juanrondon23/SALUS/Salus IV/Mejoras_Salus_IV.docx

# Cosas Necesarias Salus IV

- Borneras para las entradas de potencia de 5V y 7V, además de borneras para la salida a Puente H del driver del motor.
- Agregar mayor cantidad de GPIOs para el uso de más Ultrasonidos.
- Pensar como reemplazar PixHawk.
- Agregar Leds que indiquen el encendido de la placa y no depender de la ESP32 o Rasp.
- Amplificador para incluir un parlante.
- Agujeros pasantes para los tornillos.
- Agregarle las resistencias necesarias de Pull-Down para transistores.
- Incluir Step-Downs dentro de la PCB (Preguntar bien si lo vamos a hacer asi).

# Cosas que no funcionaron o quedaron por funcionar de PCB Salus III

# Cosas que podríamos mejorar de la placa de Salus III
