juanrondon23/SALUS/PCB_Salus_II_Prototipo_1/Prueba.pdf

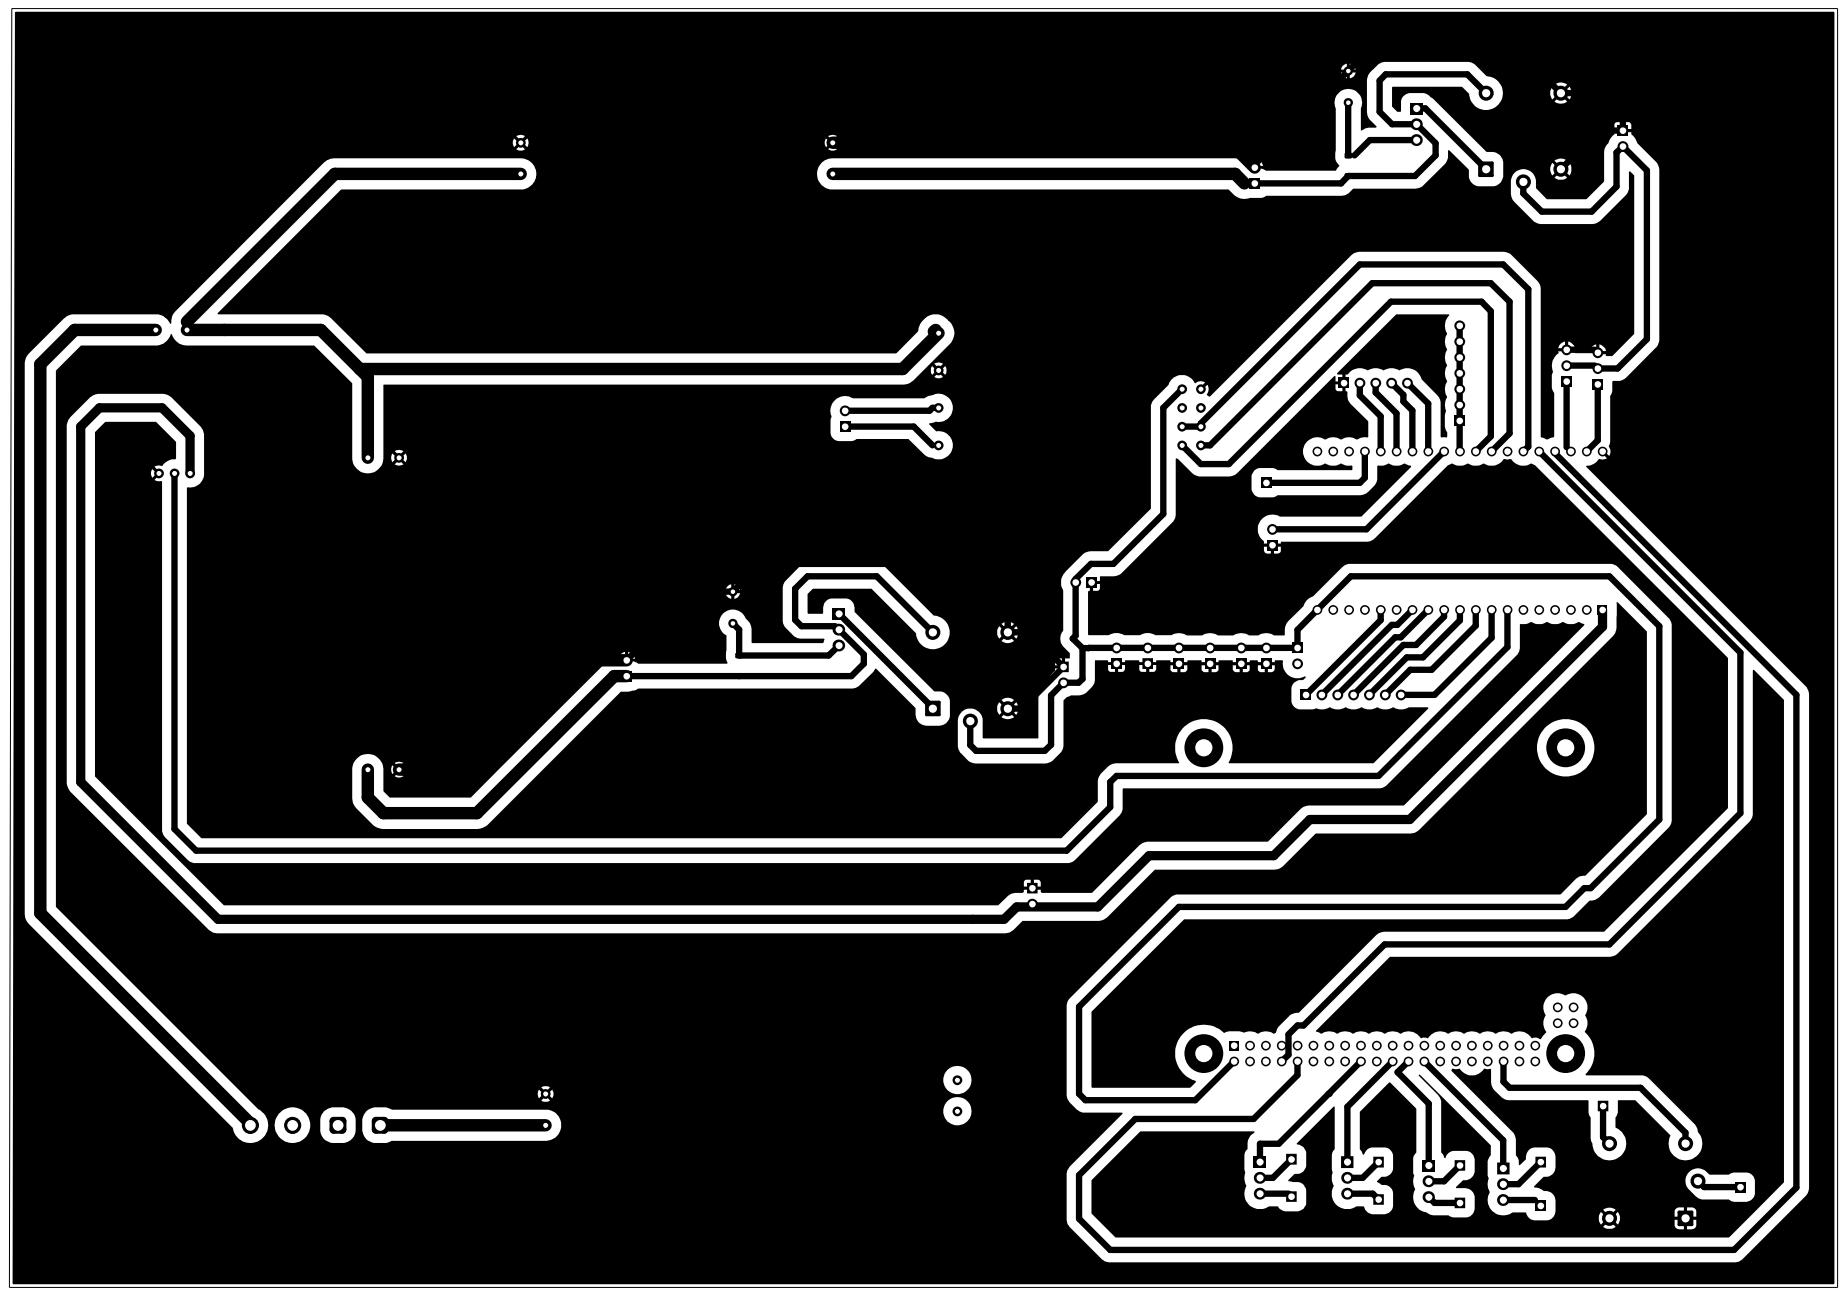
[picture p9: page 1]
