juanrondon23/SALUS/Huellas y Simbolos StepDowns/HUELLAS.pdf

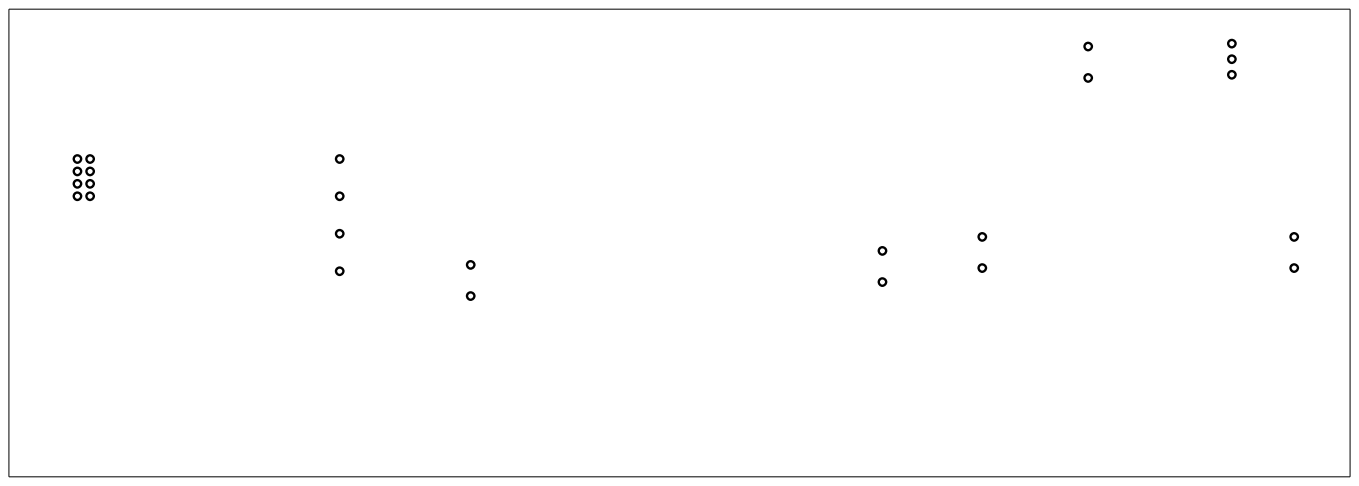
[picture p10: page 1]
