juanrondon23/SALUS/PCB_Salus_II_Prototipo_1/IMPRIMIR SIN HOJA DE DIBUJO.pdf

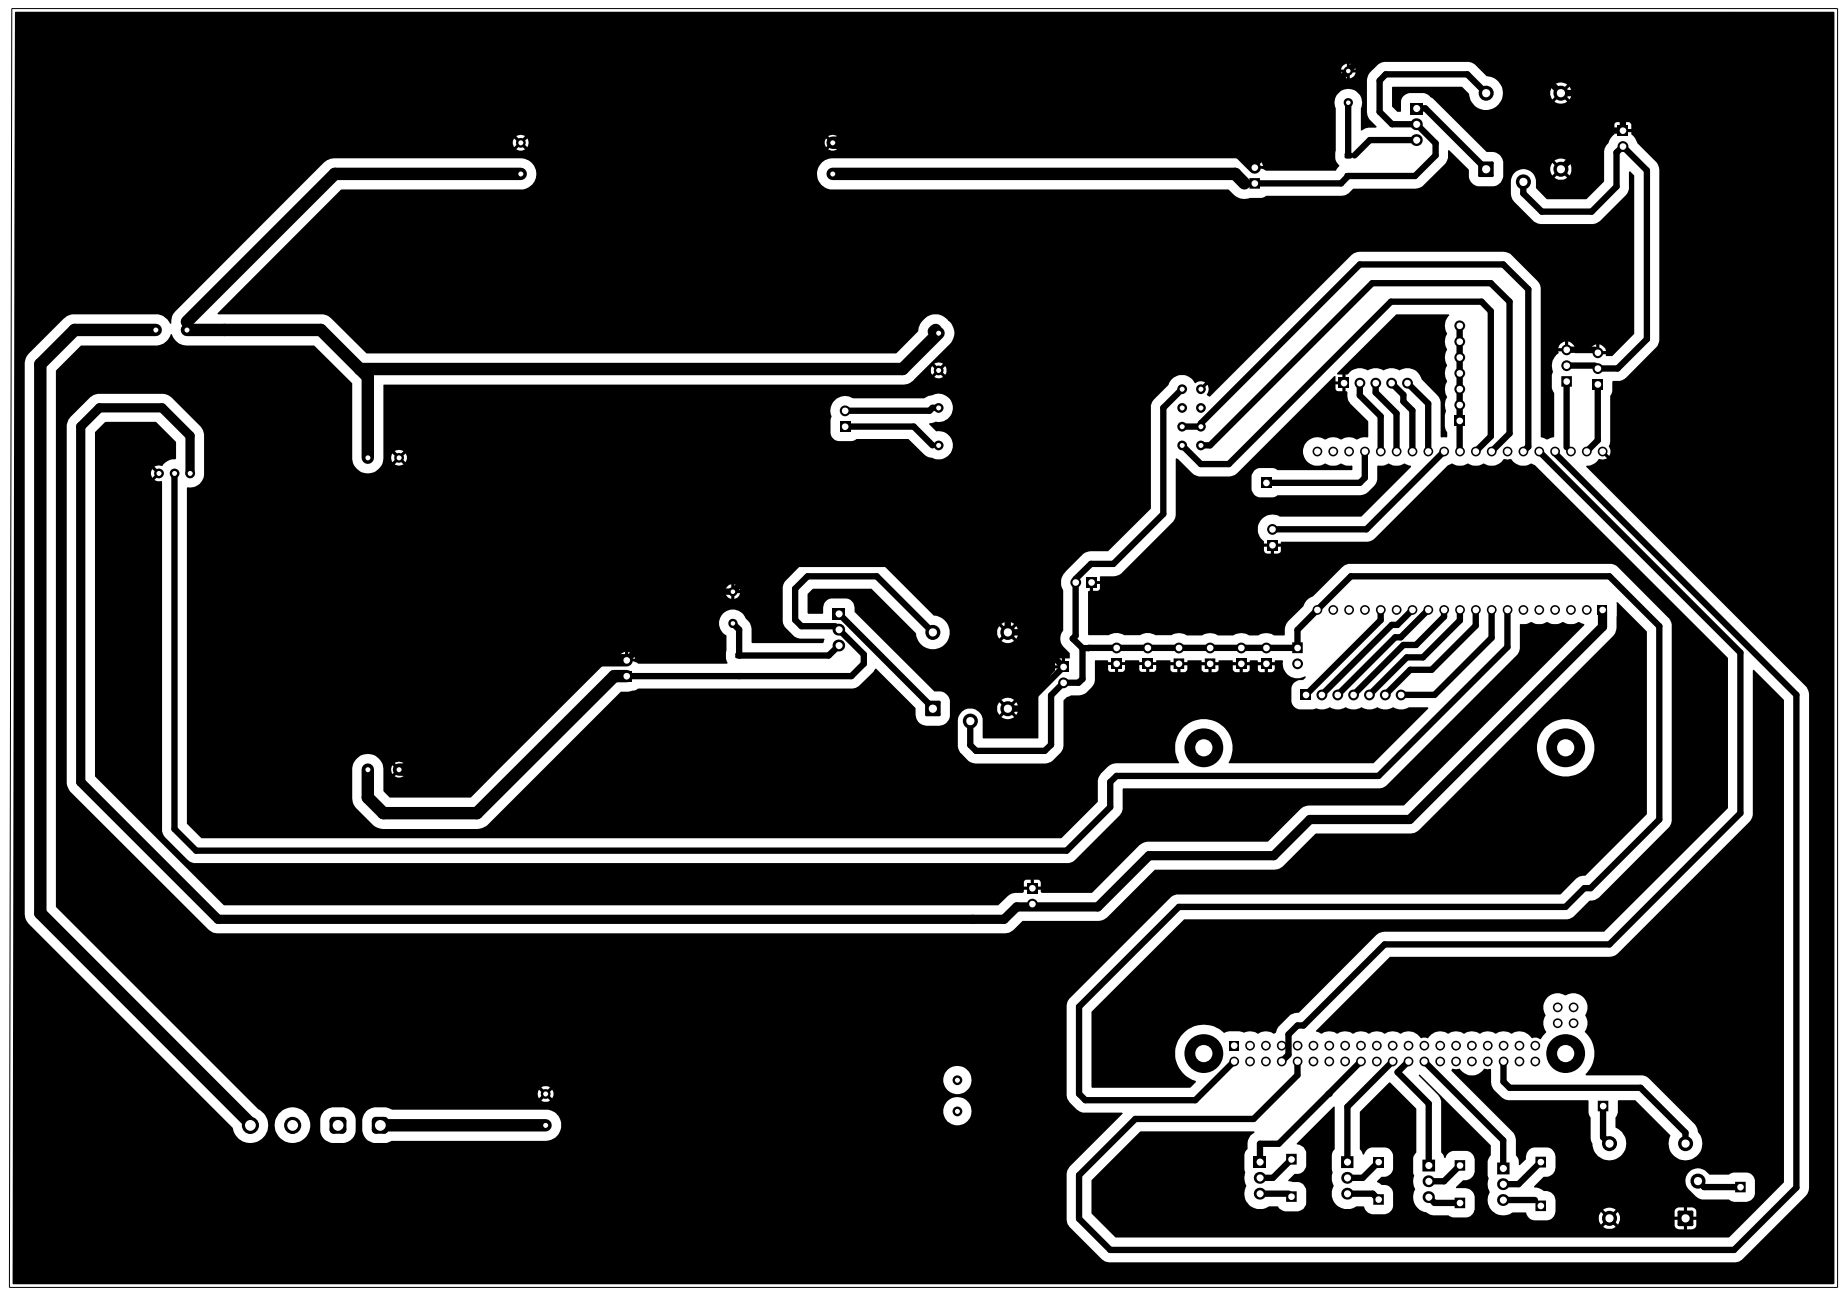
[picture p11: page 1]
