juanrondon23/SALUS/PCB_Salus_II_Prototipo_1/PCB_Salus_II_Prototipo_1-F_Cu.pdf

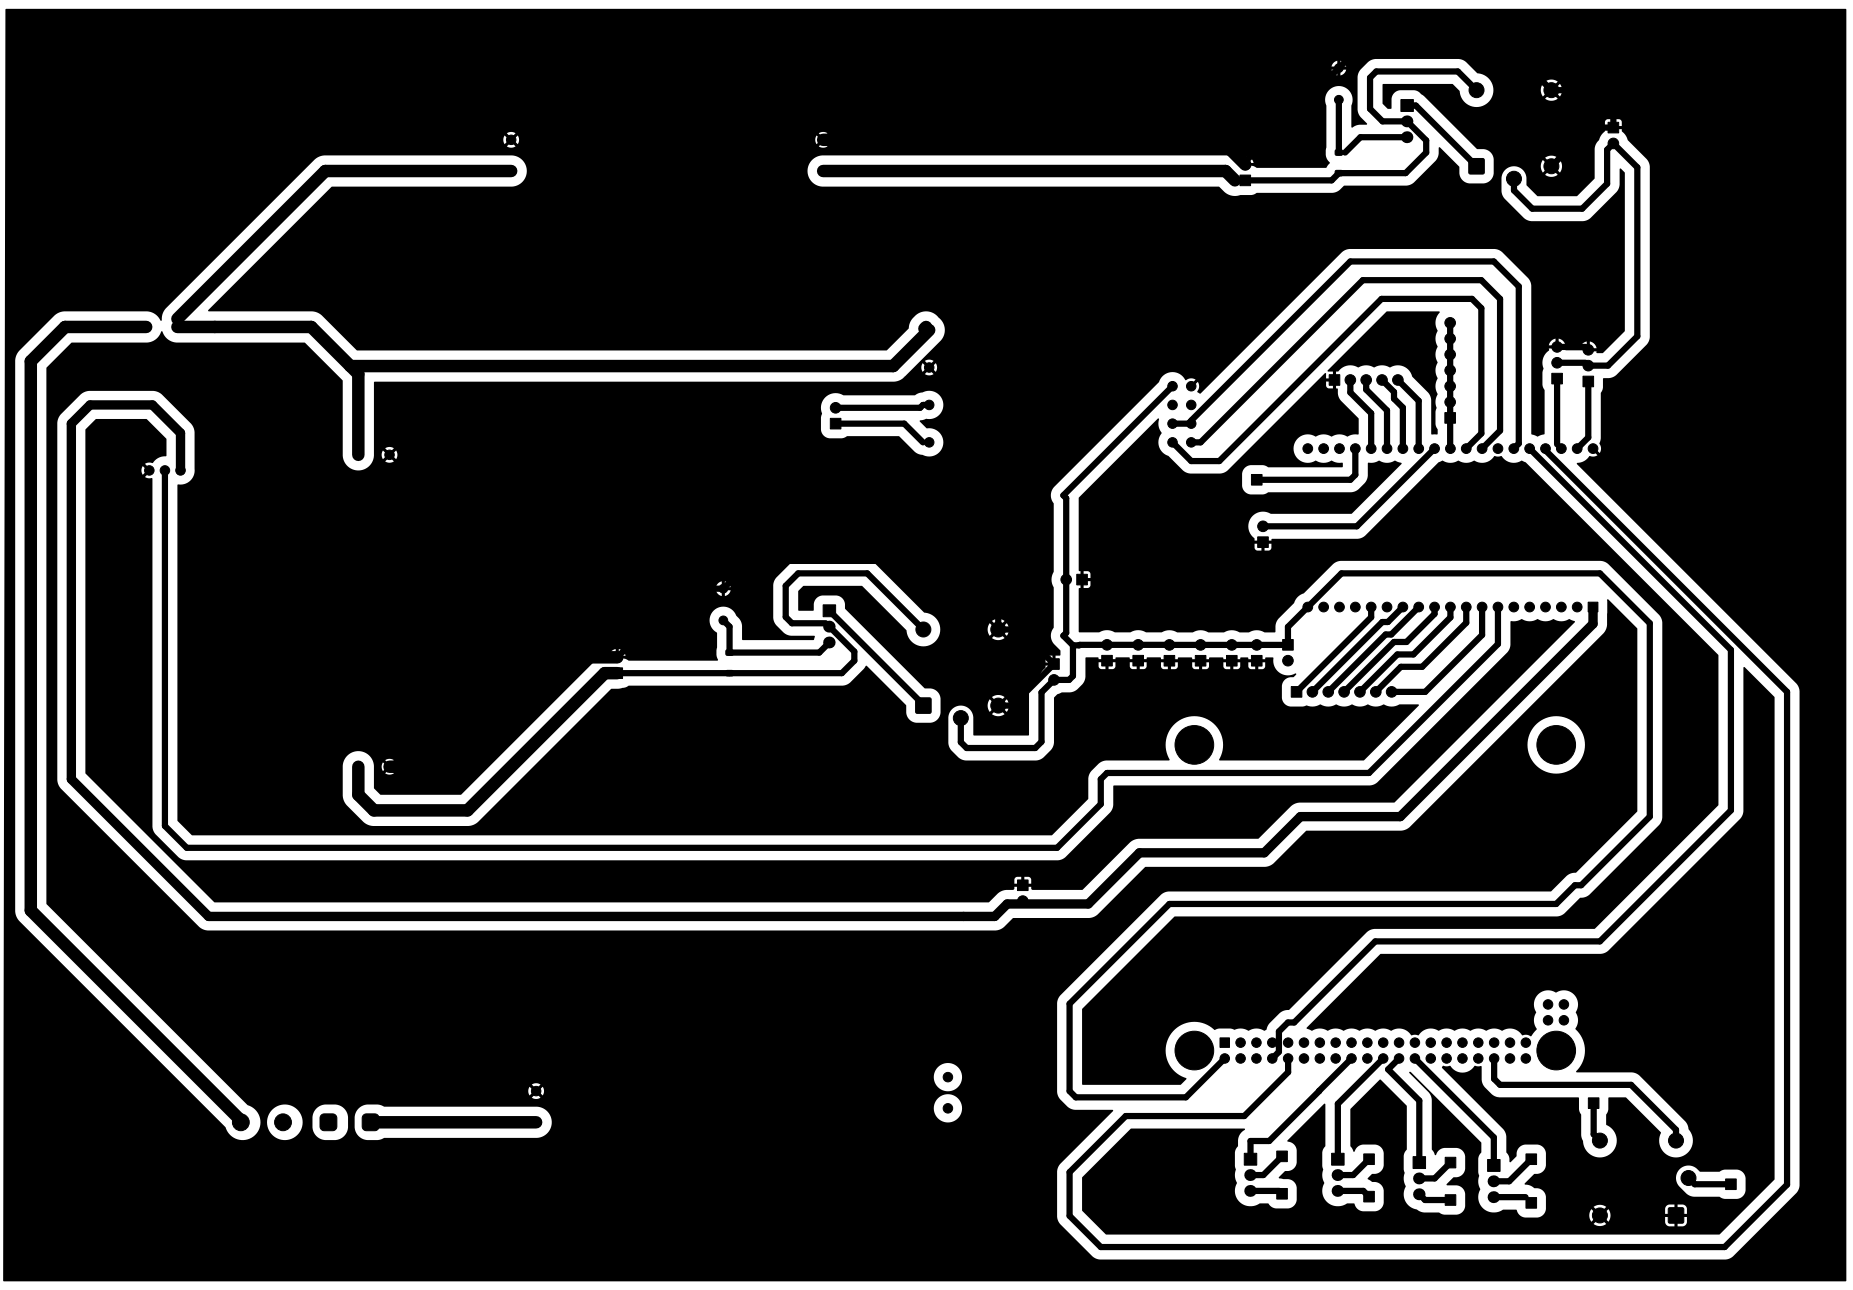
[picture p12: page 1]
