juanrondon23/SALUS/Salus III/PCB/PCB_SALUS_III/PCB_SALUS_III.kicad_pcb

## KiCad design Salus III/PCB/PCB_SALUS_III/PCB_SALUS_III.kicad_pcb (2025-12-04)

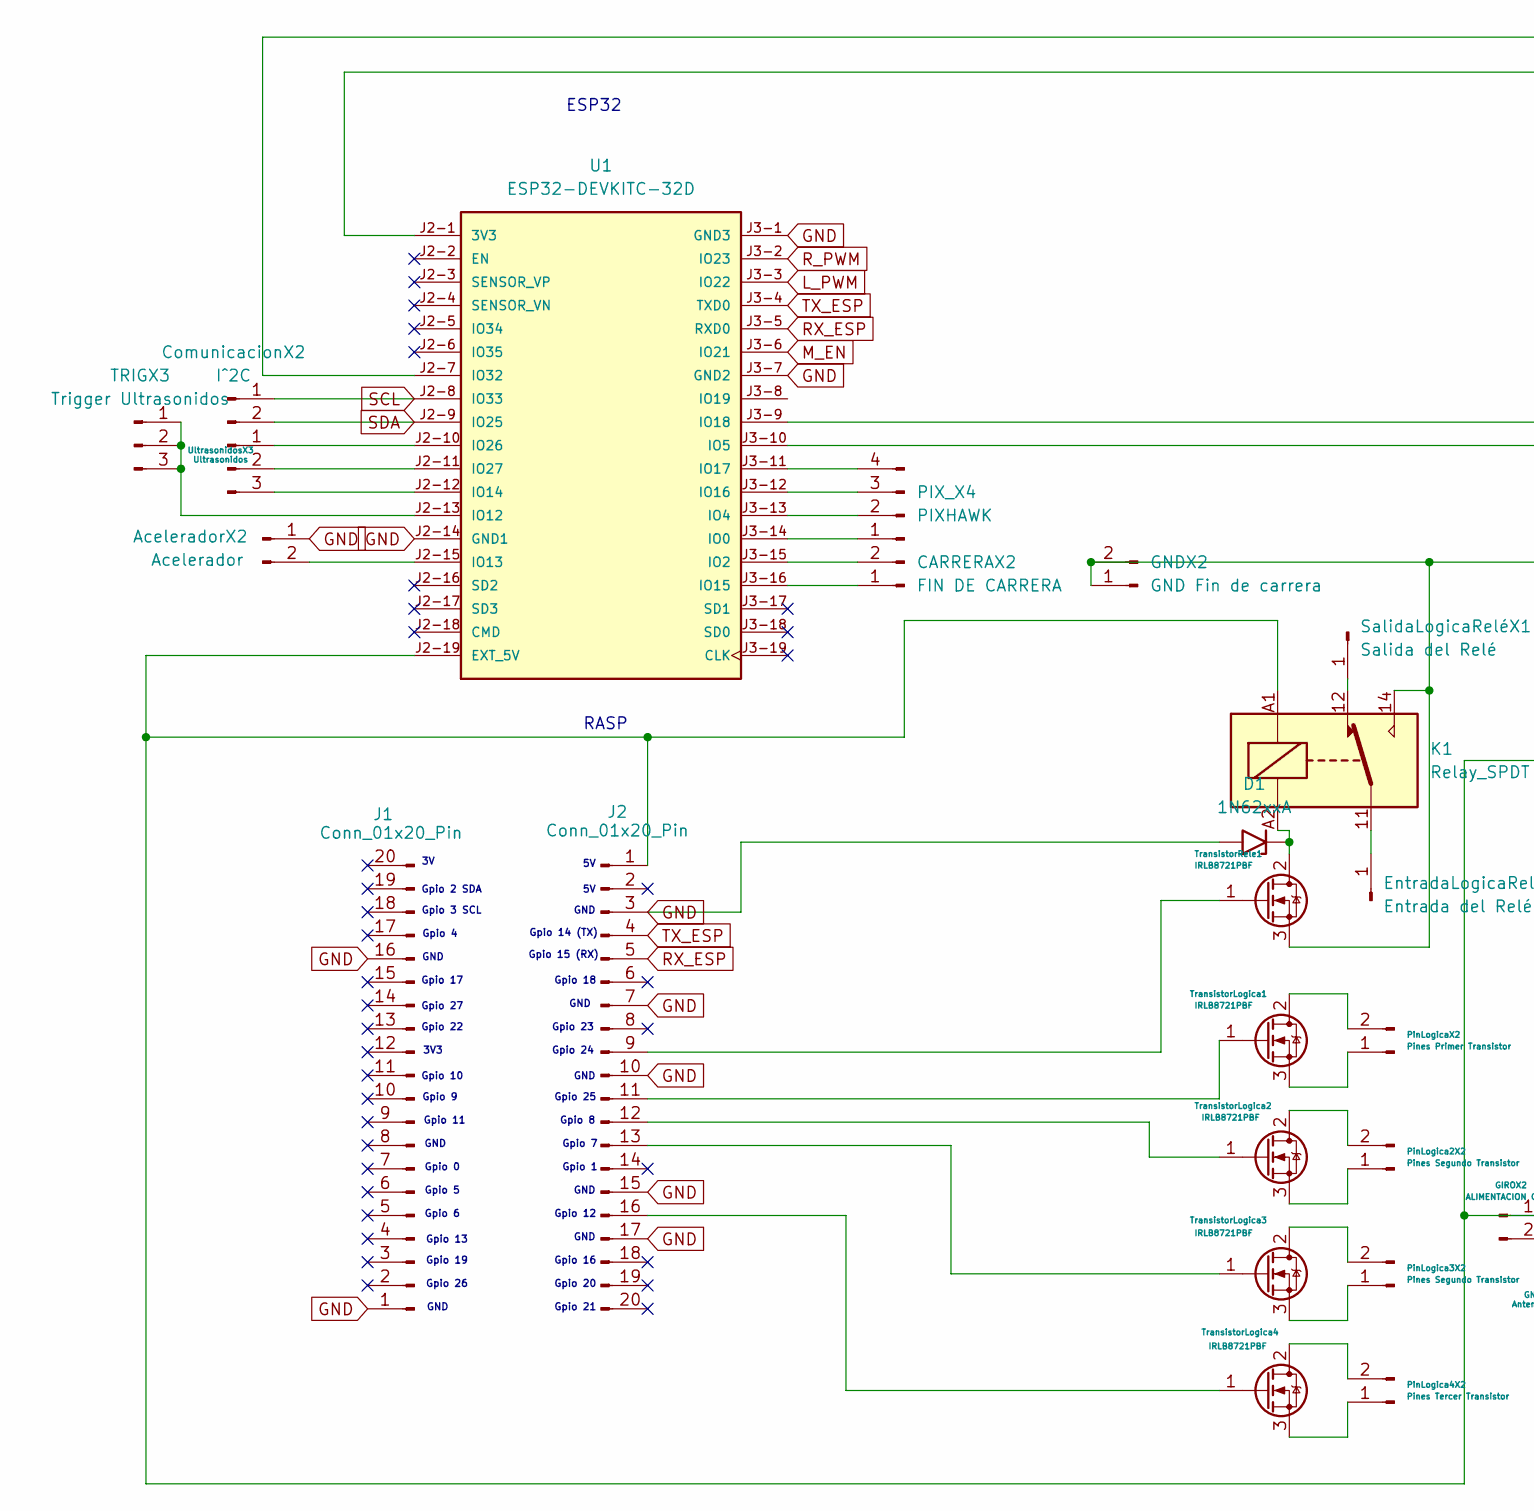
[picture p13: schematic PCB_SALUS_III.kicad_sch, PLACA SALUS III, part in row 1, column 1]

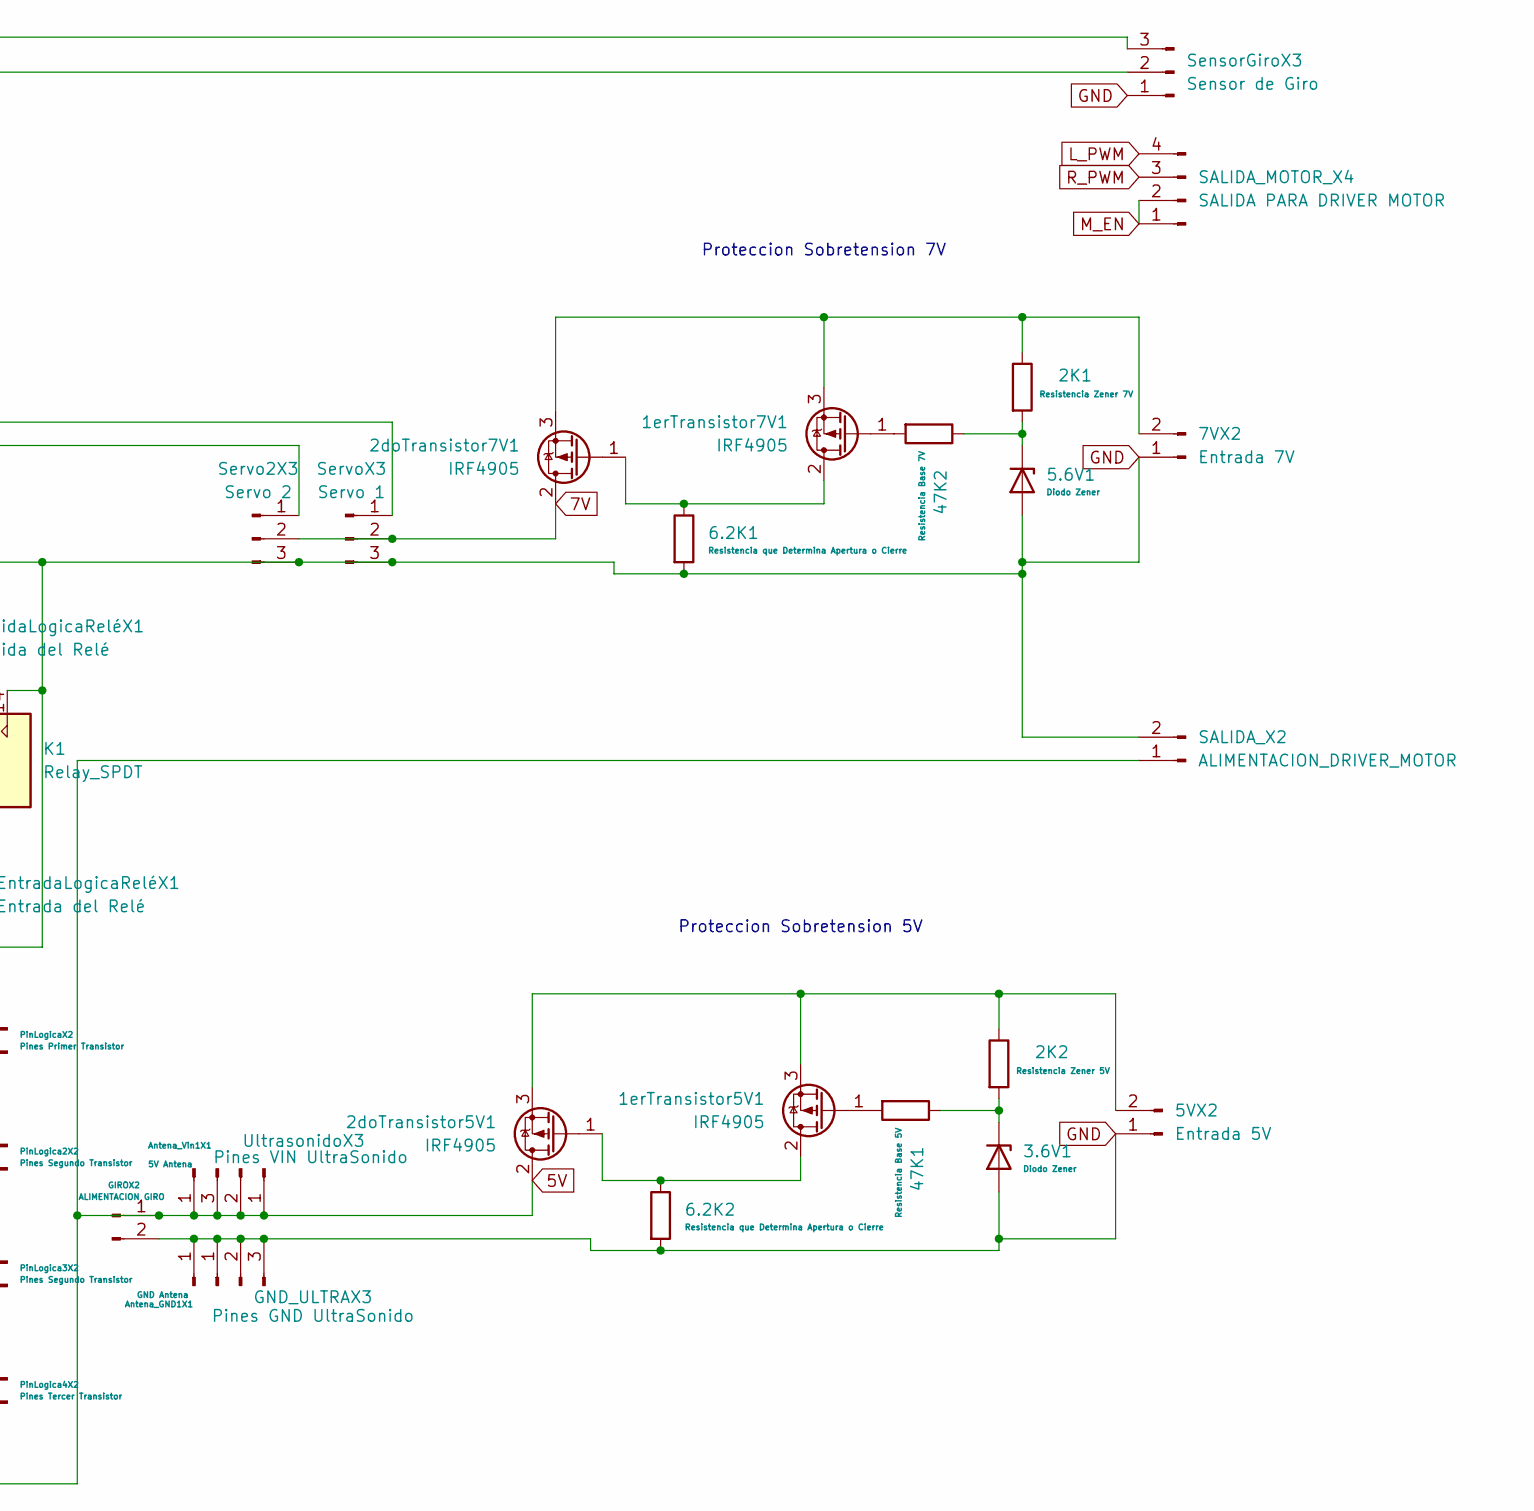
[picture p14: schematic PCB_SALUS_III.kicad_sch, PLACA SALUS III, part in row 1, column 2]

Parts:
1erTransistor5V1, 1erTransistor7V1, 2doTransistor5V1, 2doTransistor7V1: IRF4905; TO-220-3_Vertical
2K1: Resistencia Zener 7V; R_Axial_DIN0207_L6.3mm_D2.5mm_P10.16mm_Horizontal
2K2: Resistencia Zener 5V; R_Axial_DIN0207_L6.3mm_D2.5mm_P10.16mm_Horizontal
3.6V1, 5.6V1: Diodo Zener; D_DO-41_SOD81_P12.70mm_Horizontal
5VX2: Entrada 5V; PinHeader_1x02_P2.54mm_Vertical
6.2K1, 6.2K2: Resistencia que Determina Apertura o Cierre; R_Axial_DIN0207_L6.3mm_D2.5mm_P10.16mm_Horizontal
7VX2: Entrada 7V; PinHeader_1x02_P2.54mm_Vertical
47K1: Resistencia Base 5V; R_Axial_DIN0207_L6.3mm_D2.5mm_P10.16mm_Horizontal
47K2: Resistencia Base 7V; R_Axial_DIN0207_L6.3mm_D2.5mm_P10.16mm_Horizontal
AceleradorX2: Acelerador; PinHeader_1x02_P2.54mm_Vertical
Antena_GND1X1: GND Antena; PinHeader_1x01_P2.54mm_Vertical
Antena_Vin1X1: 5V Antena; PinHeader_1x01_P2.54mm_Vertical
CARRERAX2: FIN DE CARRERA; PinHeader_1x02_P2.54mm_Vertical
ComunicacionX2: I^2C; PinHeader_1x02_P2.54mm_Vertical
D1: 1N62xxA; D_DO-201AE_P12.70mm_Horizontal
EntradaLogicaReléX1: Entrada del Relé; PinHeader_1x01_P2.54mm_Vertical
GIROX2: ALIMENTACION GIRO; PinHeader_1x02_P2.54mm_Vertical
GNDX2: GND Fin de carrera; PinHeader_1x02_P2.54mm_Vertical
GND_ULTRAX3: Pines GND UltraSonido; PinHeader_1x03_P2.54mm_Vertical
J1, J2: Conn_01x20_Pin; PinHeader_1x20_P2.54mm_Vertical
K1: Relay_SPDT; Relay_SPDT_Finder_36.11
PIX_X4: PIXHAWK; PinSocket_1x04_P2.54mm_Vertical
PinLogica2X2, PinLogica3X2: Pines Segundo Transistor; PinHeader_1x02_P2.54mm_Vertical
PinLogica4X2: Pines Tercer Transistor; PinHeader_1x02_P2.54mm_Vertical
PinLogicaX2: Pines Primer Transistor; PinHeader_1x02_P2.54mm_Vertical
SALIDA_MOTOR_X4: SALIDA PARA DRIVER MOTOR; PinHeader_1x04_P2.54mm_Vertical
SALIDA_X2: ALIMENTACION_DRIVER_MOTOR; PinHeader_1x02_P2.54mm_Vertical
SalidaLogicaReléX1: Salida del Relé; PinHeader_1x01_P2.54mm_Vertical
SensorGiroX3: Sensor de Giro; PinHeader_1x03_P2.54mm_Vertical
Servo2X3: Servo 2; PinHeader_1x03_P2.54mm_Vertical
ServoX3: Servo 1; PinHeader_1x03_P2.54mm_Vertical
TRIGX3: Trigger Ultrasonidos; PinHeader_1x03_P2.54mm_Vertical
TransistorLogica1, TransistorLogica2, TransistorLogica3, TransistorLogica4: IRLB8721PBF; TO-220-3_Vertical
TransistorRele1: IRLB8721PBF; TO-220-3_Vertical
U1: ESP32-DEVKITC-32D; MODULE_ESP32-DEVKITC-32D; PARTREV V4
UltrasonidoX3: Pines VIN UltraSonido; PinHeader_1x03_P2.54mm_Vertical
UltrasonidosX3: Ultrasonidos; PinHeader_1x03_P2.54mm_Vertical

Connections:
5V: 2doTransistor5V1.2 (D), Antena_Vin1X1.1, GIROX2.1, J2.1, K1.A1, SALIDA_X2.1, U1.J2-19 (EXT_5V), UltrasonidoX3.1, UltrasonidoX3.2, UltrasonidoX3.3
7V: 2doTransistor7V1.2 (D), Servo2X3.2, ServoX3.2
GND: 3.6V1.2 (A), 5.6V1.2 (A), 5VX2.1, 6.2K1.2, 6.2K2.2, 7VX2.1, AceleradorX2.1, Antena_GND1X1.1, D1.2 (A2), GIROX2.2, GNDX2.1, GNDX2.2, GND_ULTRAX3.1, GND_ULTRAX3.2, GND_ULTRAX3.3, J1.1, J1.16, J2.3, J2.7, J2.10, J2.15, J2.17, K1.14, SALIDA_X2.2, SensorGiroX3.1, Servo2X3.3, ServoX3.3, TransistorRele1.3 (S), U1.J2-14 (GND1), U1.J3-1 (GND3), U1.J3-7 (GND2)
L_PWM: SALIDA_MOTOR_X4.4, U1.J3-3 (IO22)
M_EN: SALIDA_MOTOR_X4.1, SALIDA_MOTOR_X4.2, U1.J3-6 (IO21)
unnamed: 1erTransistor5V1.2 (D), 2doTransistor5V1.1 (G), 6.2K2.1
unnamed: 1erTransistor5V1.1 (G), 47K1.2
unnamed: 1erTransistor5V1.3 (S), 2K2.1, 2doTransistor5V1.3 (S), 5VX2.2
unnamed: 1erTransistor7V1.2 (D), 2doTransistor7V1.1 (G), 6.2K1.1
unnamed: 1erTransistor7V1.1 (G), 47K2.2
unnamed: 1erTransistor7V1.3 (S), 2K1.1, 2doTransistor7V1.3 (S), 7VX2.2
unnamed: 2K2.2, 3.6V1.1 (K), 47K1.1
unnamed: 2K1.2, 5.6V1.1 (K), 47K2.1
unnamed: AceleradorX2.2, U1.J2-15 (IO13)
unnamed: CARRERAX2.1, U1.J3-16 (IO15)
unnamed: CARRERAX2.2, U1.J3-15 (IO2)
unnamed: D1.1 (A1), K1.A2, TransistorRele1.2 (D)
unnamed: EntradaLogicaReléX1.1, K1.11
unnamed: J2.9, TransistorRele1.1 (G)
unnamed: J2.11, TransistorLogica1.1 (G)
unnamed: J2.12, TransistorLogica2.1 (G)
unnamed: J2.13, TransistorLogica3.1 (G)
unnamed: J2.16, TransistorLogica4.1 (G)
unnamed: PIX_X4.1, U1.J3-14 (IO0)
unnamed: PIX_X4.2, U1.J3-13 (IO4)
unnamed: PIX_X4.3, U1.J3-12 (IO16)
unnamed: PIX_X4.4, U1.J3-11 (IO17)
unnamed: PinLogica2X2.1, TransistorLogica2.3 (S)
unnamed: PinLogica2X2.2, TransistorLogica2.2 (D)
unnamed: PinLogica3X2.1, TransistorLogica3.3 (S)
unnamed: PinLogica3X2.2, TransistorLogica3.2 (D)
unnamed: PinLogica4X2.1, TransistorLogica4.3 (S)
unnamed: PinLogica4X2.2, TransistorLogica4.2 (D)
unnamed: PinLogicaX2.1, TransistorLogica1.3 (S)
unnamed: PinLogicaX2.2, TransistorLogica1.2 (D)
unnamed: K1.12, SalidaLogicaReléX1.1
unnamed: SensorGiroX3.2, U1.J2-1 (3V3)
unnamed: SensorGiroX3.3, U1.J2-7 (IO32)
unnamed: Servo2X3.1, U1.J3-10 (IO5)
unnamed: ServoX3.1, U1.J3-9 (IO18)
unnamed: TRIGX3.1, TRIGX3.2, TRIGX3.3, U1.J2-13 (IO12)
unnamed: U1.J2-12 (IO14), UltrasonidosX3.3
unnamed: U1.J2-10 (IO26), UltrasonidosX3.1
unnamed: U1.J2-11 (IO27), UltrasonidosX3.2
RX_ESP: J2.5, U1.J3-5 (RXD0)
R_PWM: SALIDA_MOTOR_X4.3, U1.J3-2 (IO23)
SCL: ComunicacionX2.1, U1.J2-8 (IO33)
SDA: ComunicacionX2.2, U1.J2-9 (IO25)
TX_ESP: J2.4, U1.J3-4 (TXD0)

Notes on the sheet:
Gpio 10
Gpio 8
GND
Gpio 18
Gpio 24
Gpio 14 (TX)
Gpio 12
Proteccion Sobretension 7V
3V3
Gpio 11
Proteccion Sobretension 5V
Gpio 3 SCL
Gpio 27
Gpio 0
Gpio 2 SDA
Gpio 17
RASP
Gpio 21
Gpio 23
Gpio 25
Gpio 9
Gpio 6
Gpio 7
Gpio 4
Gpio 22
Gpio 13
Gpio 16
ESP32
Gpio 20
Gpio 5
Gpio 19
Gpio 26
Gpio 15 (RX)
Gpio 1

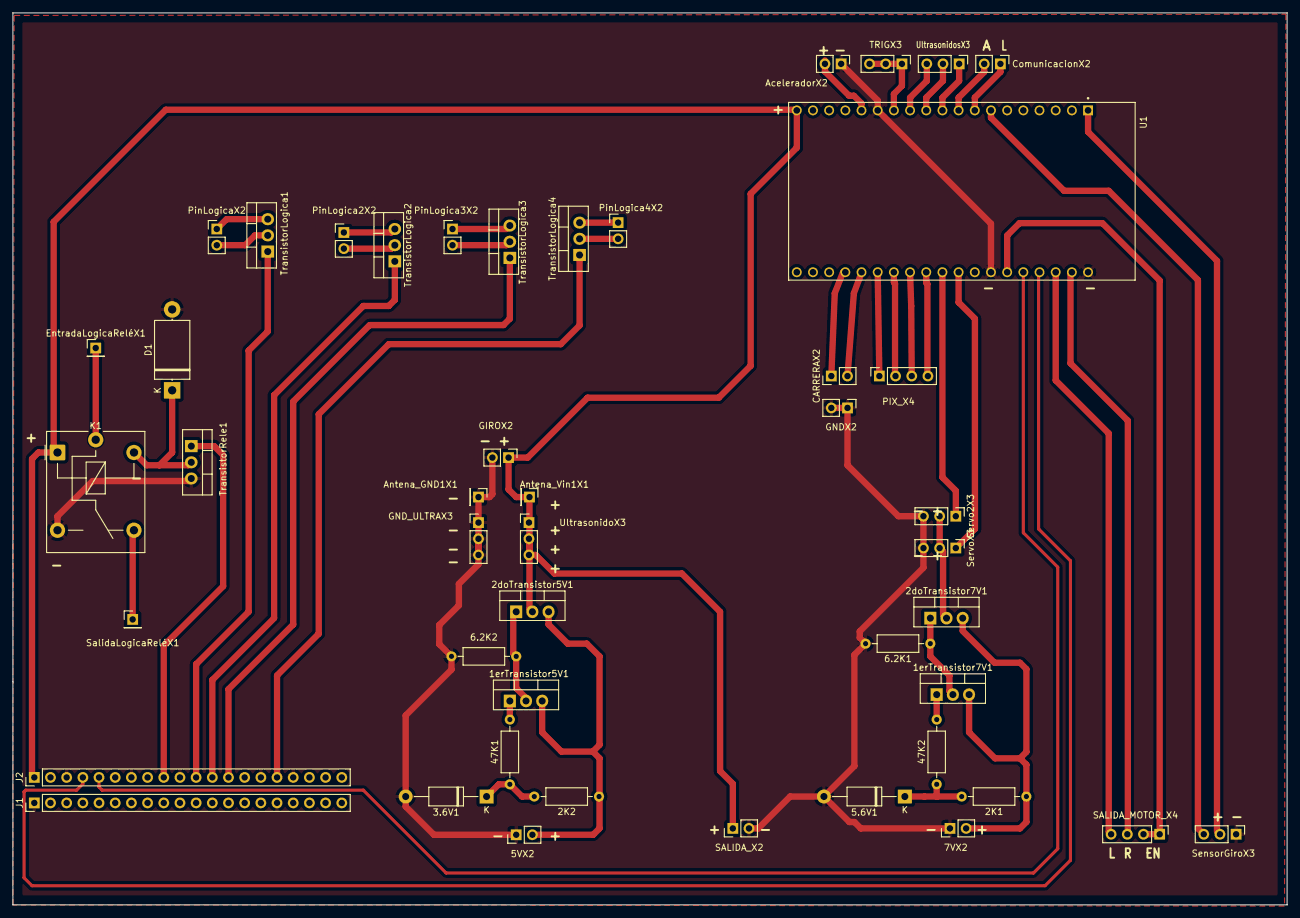
[picture p15: board PCB_SALUS_III.kicad_pcb from above]

Board: 2 copper layers, 200.0 x 140.0 mm, 47 parts (0 on the bottom side), 49 nets.
