juanrondon23/SALUS/PCB_Salus_II_Prototipo_1/PCB_Salus_II_Prototipo_1.kicad_pcb

## KiCad design PCB_Salus_II_Prototipo_1/PCB_Salus_II_Prototipo_1.kicad_pcb (2025-09-17)

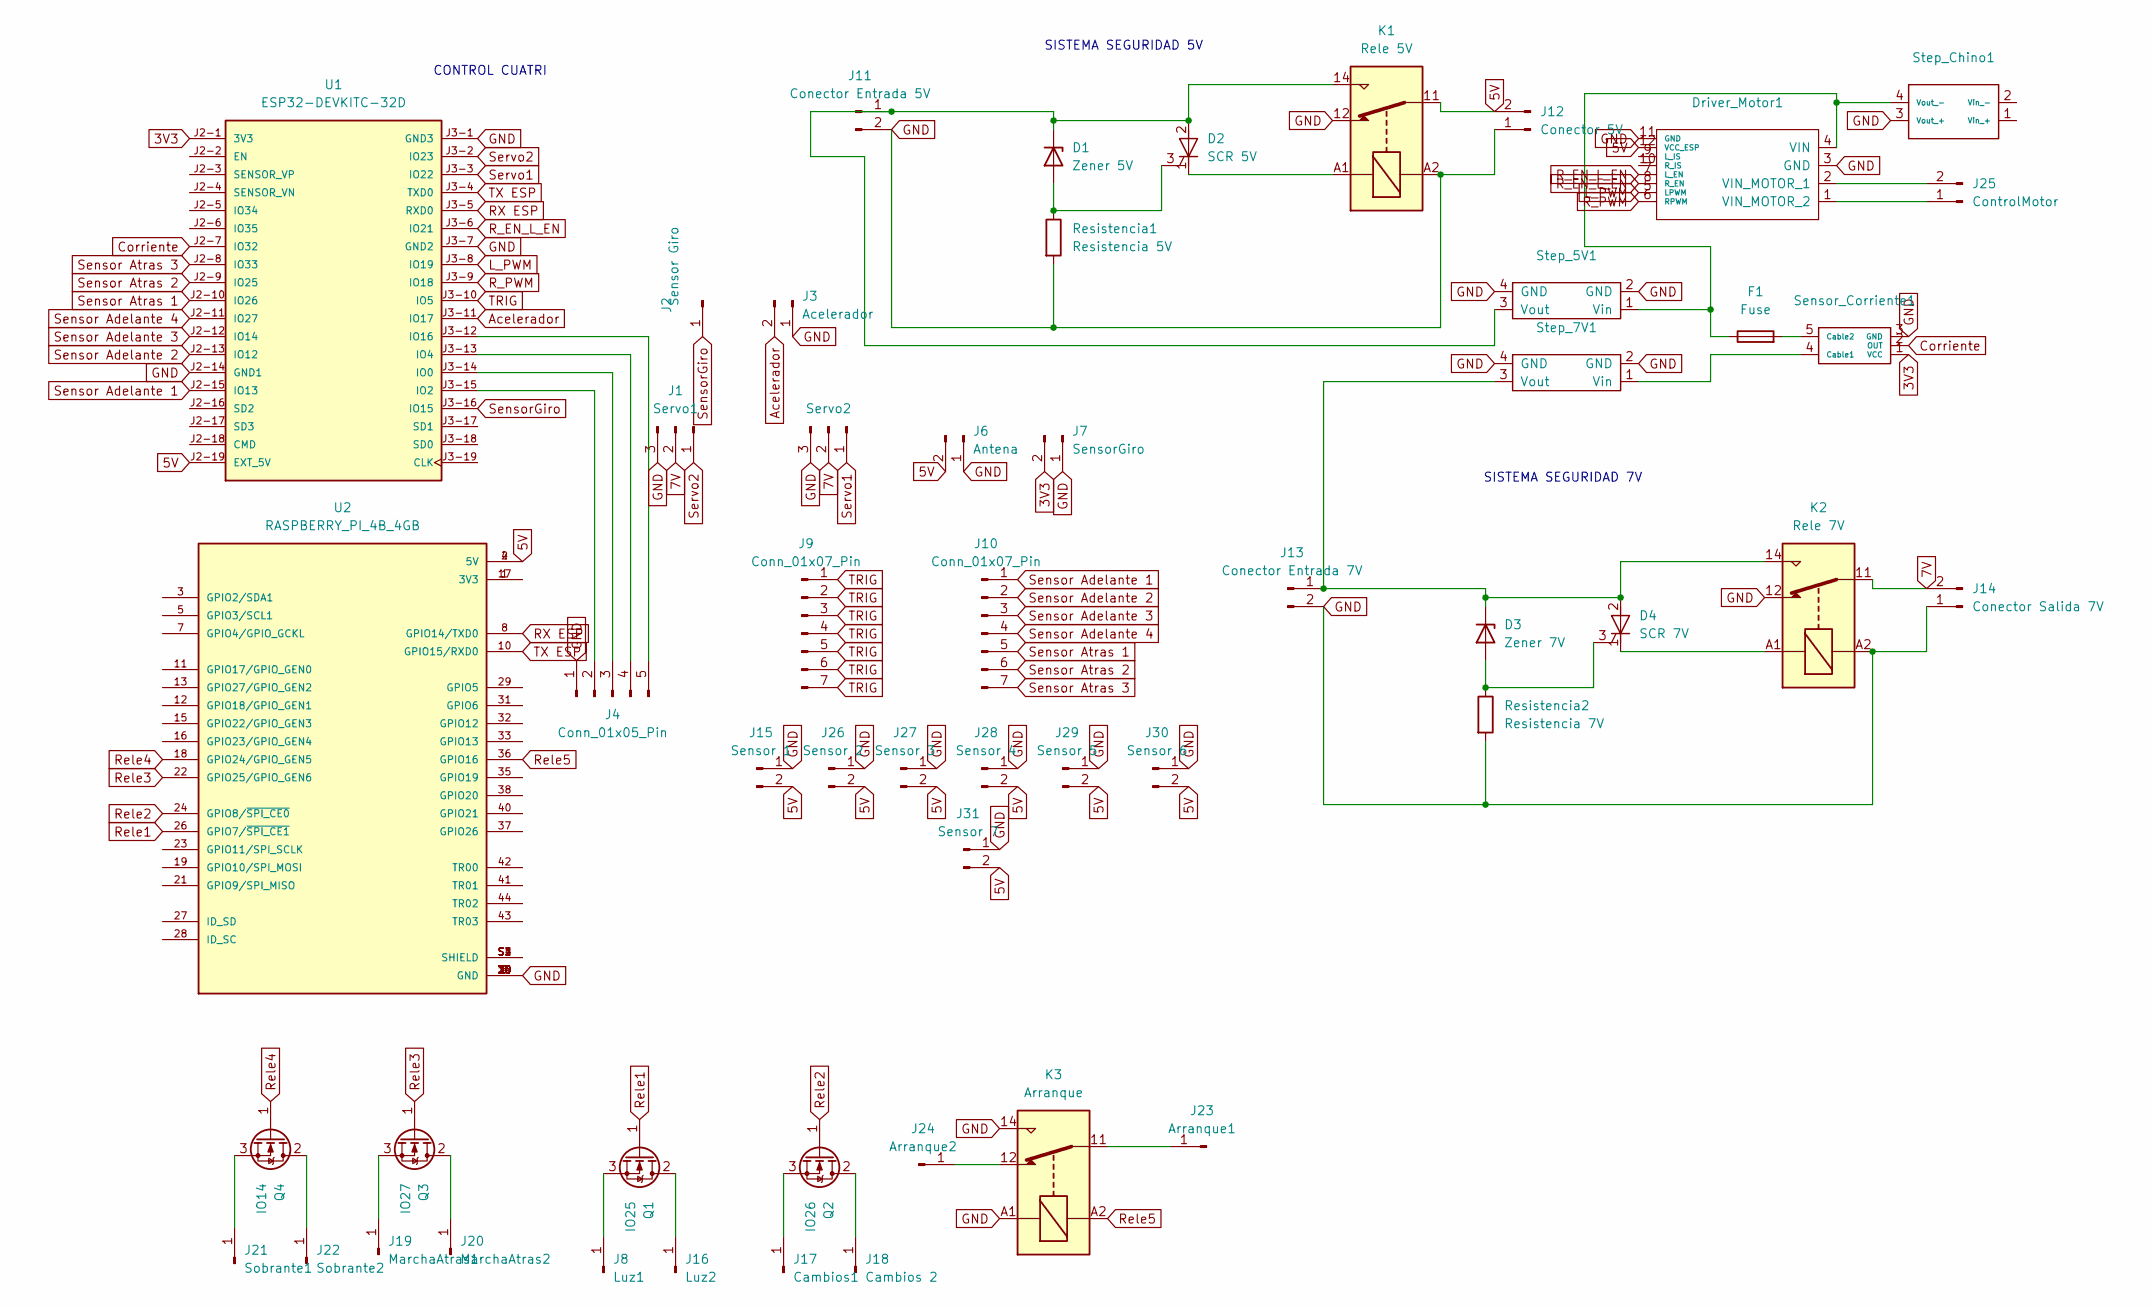
[picture p16: schematic PCB_Salus_II_Prototipo_1.kicad_sch]

Parts:
D1: Zener 5V; D_SOD-123
D2: SCR 5V; TO-220-3_Vertical
D3: Zener 7V; D_SOD-123
D4: SCR 7V; TO-220-3_Vertical
Driver_Motor1: Driver_Motor
F1: Fuse; Fuseholder_Clip-5x20mm_Eaton_1A5601-01_Inline_P20.80x6.76mm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
J1: Servo1; PinHeader_1x03_P2.54mm_Vertical
J2: Sensor Giro; PinHeader_1x01_P2.54mm_Vertical
J3: Acelerador; PinHeader_1x02_P2.54mm_Vertical
J4: Conn_01x05_Pin; PinHeader_1x05_P2.54mm_Vertical
J5: Servo2; PinHeader_1x03_P2.54mm_Vertical
J6: Antena; PinHeader_1x02_P2.54mm_Vertical
J7: SensorGiro; PinHeader_1x02_P2.54mm_Vertical
J8: Luz1; PinHeader_1x01_P2.54mm_Vertical
J9, J10: Conn_01x07_Pin; PinHeader_1x07_P2.54mm_Vertical
J11: Conector Entrada 5V; PinHeader_1x02_P2.54mm_Vertical
J12: Conector 5V; PinHeader_1x02_P2.54mm_Vertical
J13: Conector Entrada 7V; PinHeader_1x02_P2.54mm_Vertical
J14: Conector Salida 7V; PinHeader_1x02_P2.54mm_Vertical
J15: Sensor 1; PinHeader_1x02_P2.54mm_Vertical
J16: Luz2; PinHeader_1x01_P2.54mm_Vertical
J17: Cambios1; PinHeader_1x01_P2.54mm_Vertical
J18: Cambios 2; PinHeader_1x01_P2.54mm_Vertical
J19: MarchaAtras1; PinHeader_1x01_P2.54mm_Vertical
J20: MarchaAtras2; PinHeader_1x01_P2.54mm_Vertical
J21: Sobrante1; PinHeader_1x01_P2.54mm_Vertical
J22: Sobrante2; PinHeader_1x01_P2.54mm_Vertical
J23: Arranque1; PinHeader_1x01_P2.54mm_Vertical
J24: Arranque2; PinHeader_1x01_P2.54mm_Vertical
J25: ControlMotor; PinHeader_1x02_P2.54mm_Vertical
J26: Sensor 2; PinHeader_1x02_P2.54mm_Vertical
J27: Sensor 3; PinHeader_1x02_P2.54mm_Vertical
J28: Sensor 4; PinHeader_1x02_P2.54mm_Vertical
J29: Sensor 5; PinHeader_1x02_P2.54mm_Vertical
J30: Sensor 6; PinHeader_1x02_P2.54mm_Vertical
J31: Sensor 7; PinHeader_1x02_P2.54mm_Vertical
K1: Rele 5V; Relay_SPDT_Finder_36.11
K2: Rele 7V; Relay_SPDT_Finder_36.11
K3: Arranque; Relay_SPDT_Finder_36.11
Q1: IO25; TO-220-3_Vertical
Q2: IO26; TO-220-3_Vertical
Q3: IO27; TO-220-3_Vertical
Q4: IO14; TO-220-3_Vertical
Resistencia1: Resistencia 5V; R_Axial_DIN0204_L3.6mm_D1.6mm_P5.08mm_Horizontal
Resistencia2: Resistencia 7V; R_Axial_DIN0204_L3.6mm_D1.6mm_P5.08mm_Horizontal
Sensor_Corriente1: Sensor_Corriente
Step_5V1, Step_7V1: XL4016
Step_Chino1: Step_Down_Chinp
U1: ESP32-DEVKITC-32D; MODULE_ESP32-DEVKITC-32D; PARTREV V4
U2: RASPBERRY_PI_4B_4GB; MODULE_RASPBERRY_PI_4B_4GB; PARTREV 4

Connections:
3V3: J7.2, Sensor_Corriente1.1 (VCC), U1.J2-1 (3V3)
7V: J1.2, J5.2, J14.2, K2.11
Acelerador: J3.2, U1.J3-11 (IO17)
Corriente: Sensor_Corriente1.2 (OUT), U1.J2-7 (IO32)
L_PWM: Driver_Motor1.5 (LPWM), U1.J3-8 (IO19)
unnamed: D1.2 (A), D2.3 (G), Resistencia1.1
unnamed: D1.1 (K), D2.2 (A), J11.1, K1.14, Step_5V1.3 (Vout)
unnamed: D2.1 (K), K1.A1
unnamed: D3.2 (A), D4.3 (G), Resistencia2.1
unnamed: D3.1 (K), D4.2 (A), J13.1, K2.14, Step_7V1.3 (Vout)
unnamed: D4.1 (K), K2.A1
unnamed: Driver_Motor1.4 (VIN), F1.1, Step_5V1.1 (Vin), Step_Chino1.4 (Vout_-)
unnamed: Driver_Motor1.2 (VIN_MOTOR_1), J25.2
unnamed: Driver_Motor1.1 (VIN_MOTOR_2), J25.1
unnamed: J4.2, U1.J3-15 (IO2)
unnamed: J4.3, U1.J3-14 (IO0)
unnamed: J4.4, U1.J3-13 (IO4)
unnamed: J4.5, U1.J3-12 (IO16)
unnamed: J8.1, Q1.3 (S)
unnamed: J16.1, Q1.2 (D)
unnamed: J17.1, Q2.3 (S)
unnamed: J18.1, Q2.2 (D)
unnamed: J19.1, Q3.3 (S)
unnamed: J20.1, Q3.2 (D)
unnamed: J21.1, Q4.3 (S)
unnamed: J22.1, Q4.2 (D)
unnamed: J23.1, K3.11
unnamed: J24.1, K3.12
unnamed: Sensor_Corriente1.4 (Cable1), Step_7V1.1 (Vin)
unnamed: F1.2, Sensor_Corriente1.5 (Cable2)
unnamed: U2.1 (3V3), U2.17 (3V3)
unnamed: U2.S1 (SHIELD), U2.S2 (SHIELD), U2.S3 (SHIELD), U2.S4 (SHIELD)
RX ESP: U1.J3-5 (RXD0), U2.8 (GPIO14/TXD0)
R_EN_L_EN: Driver_Motor1.7 (L_EN), Driver_Motor1.8 (R_EN), U1.J3-6 (IO21)
R_PWM: Driver_Motor1.6 (RPWM), U1.J3-9 (IO18)
Rele1: Q1.1 (G), U2.26 (GPIO7/~SPI_CE1)
Rele2: Q2.1 (G), U2.24 (GPIO8/~SPI_CE0)
Rele3: Q3.1 (G), U2.22 (GPIO25/GPIO_GEN6)
Rele4: Q4.1 (G), U2.18 (GPIO24/GPIO_GEN5)
Rele5: K3.A2, U2.36 (GPIO16)
Sensor Adelante 1: J10.1, U1.J2-15 (IO13)
Sensor Adelante 2: J10.2, U1.J2-13 (IO12)
Sensor Adelante 3: J10.3, U1.J2-12 (IO14)
Sensor Adelante 4: J10.4, U1.J2-11 (IO27)
Sensor Atras 1: J10.5, U1.J2-10 (IO26)
Sensor Atras 2: J10.6, U1.J2-9 (IO25)
Sensor Atras 3: J10.7, U1.J2-8 (IO33)
SensorGiro: J2.1, U1.J3-16 (IO15)
Servo1: J5.1, U1.J3-3 (IO22)
Servo2: J1.1, U1.J3-2 (IO23)
TRIG: J9.1, J9.2, J9.3, J9.4, J9.5, J9.6, J9.7, U1.J3-10 (IO5)
TX ESP: U1.J3-4 (TXD0), U2.10 (GPIO15/RXD0)

Notes on the sheet:
SISTEMA SEGURIDAD 5V
CONTROL CUATRI
SISTEMA SEGURIDAD 7V

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
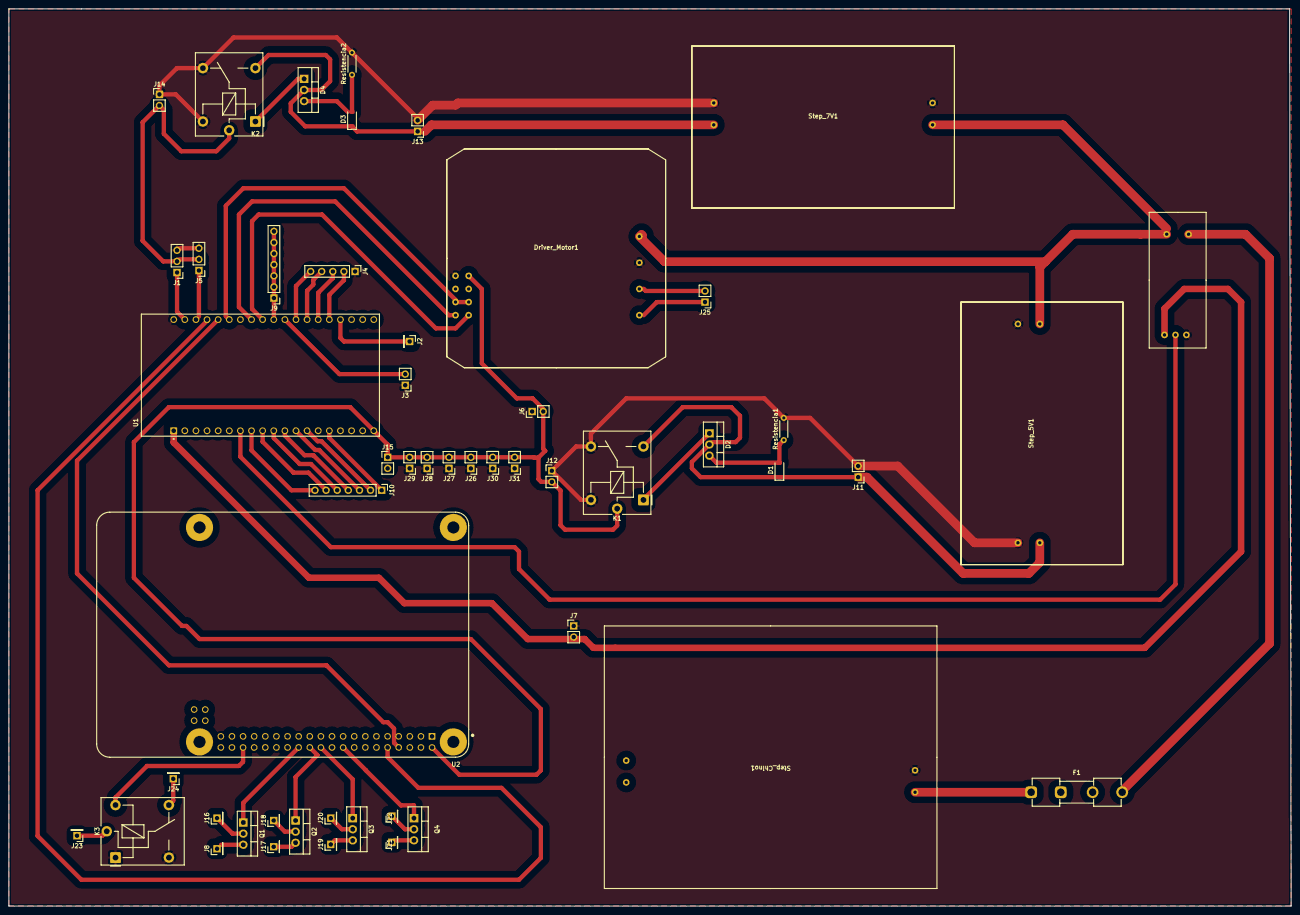
[picture p17: board PCB_Salus_II_Prototipo_1.kicad_pcb from above]

Board: 2 copper layers, 293.0 x 205.0 mm, 52 parts (0 on the bottom side), 54 nets.
