juanrondon23/SALUS/Programas/Cuatri ESP32/Programa ESP32/src/main.cpp

#include <Arduino.h>
#include "../include/LibreriaCuatri.h"
#include <ArduinoOTA.h>
#include <WiFi.h>

//defino la conexion a WiFi
const char* ssid = ("ESPcuatri");
const char* contrasena = ("teamcit2024");
void setup() {
  InicializaUart();  // Inicializa UART0 con 115200 baudios
  InicializaWiFi(ssid,contrasena); //hago el llamado desde el main para que se conecte al WiFi
  InicializaOTA();
  InicializaParametrosAceleracion();          // deja pines listos
  delay(1000);
  
}

void loop() {
  String mensaje;
  if (RecibirMensaje(mensaje)) {
    // Procesar el mensaje recibido
    EnviarMensaje("Mensaje recibido: " + mensaje);
  }
  AceleradorConPixhawk(); //llama a la funcion que lee el PWM del Pixhawk y lo envia al ESC
  ArduinoOTA.handle(); //Importante para el funcionamiento del OTA llama a la ESP a revisar el estado 
  EnviarMensaje("ESP32 conectado a Raspberry Pi");
  delay(30);
}
