juanrondon23/SALUS/(commit log)

2025-06-18 Se agregan las primeras cosas de salus
    [PCB_Salus_II_Prototipo_1.kicad_pcb, PCB_Salus_II_Prototipo_1.kicad_sch]
2025-06-18 Queda por agregar los ultrasonidos
    [PCB_Salus_II_Prototipo_1.kicad_pcb, StepDowns.kicad_pcb, StepDowns.kicad_sch]
2025-06-18 Modifique la fuente de alimentacion de sensor de Corriente y de giro
    [PCB_Salus_II_Prototipo_1.kicad_pcb, PCB_Salus_II_Prototipo_1.kicad_sch]
2025-06-26 Se agrego sensores ultrasonidos
    [PCB_Salus_II_Prototipo_1.kicad_pcb, PCB_Salus_II_Prototipo_1.kicad_sch]
2025-06-27 Se agrego el codigo del cuatri y si empezo la programacion para la ESP32. Puntualmente se empezo con la comunicacion UART con RASP PI
2025-06-28 Se agrego OTA para la ESP32
2025-06-30 Agregue la aceleracion del Cuatri con PixHawk, esto es con la funcion AnalogWrite
2025-06-30 Modifique las funciones que generan señales PWM en el ESP por recomendacion de COPILOT (Probar y si no funciona usar el anteriori)
2025-06-30 Se aplica logica del funcionamiento de Reversa
    [LibreriaCuatri.cpp, main.cpp]
2025-09-04 Se agrega programacion via OTA con ESP como punto de acceso
2025-09-16 Probado la compilacion y arreglado los problemas
    [LibreriaCuatri.cpp]
2025-09-17 Se cambio la Ip para configurarlacon WiFi
    [PCB_Salus_II_Prototipo_1.kicad_pcb, PCB_Salus_II_Prototipo_1.kicad_sch]
2025-09-19 Se mergeo Giro para solucionar errores y se modifico conexion de Rele
    [PCB_Salus_II_Prototipo_1.kicad_sch]
2025-09-19 Revert "Se mergeo Giro para solucionar errores y se modifico conexion de Rele"
    This reverts commit cd5eaa53754aee94d3ef285bc9ee5ec6b973b34c.
    [PCB_Salus_II_Prototipo_1.kicad_sch]
2025-09-19 se volvio al commit prueba para solucionar error
    [PCB_Salus_II_Prototipo_1 (3).kicad_sch]
2025-09-19 se agrego mensaje para modificar conexion Rele
    [PCB_Salus_II_Prototipo_1 (3).kicad_sch, PCB_Salus_II_Prototipo_1.kicad_sch]
2025-10-24 Se comenzó con la PCB para SALUS III
    [PCB_SALUS_III.kicad_pcb, PCB_SALUS_III.kicad_sch, StepDowns.kicad_pcb, StepDowns.kicad_sch]
2025-11-03 Se agregaron Modificaciones de PCB. Queda modificar raspy por tira de pines
    [PCB_SALUS_III.kicad_pcb, PCB_SALUS_III.kicad_sch]
2025-11-10 Parece ser la PCB definitiva de SALUS III por lo menos parte logica
    [PCB_SALUS_III.kicad_pcb, PCB_SALUS_III.kicad_sch]
2025-11-19 se agrego el diodo TVS a probar para proteger de cierres de Relé
    [PCB_SALUS_III.kicad_pcb, PCB_SALUS_III.kicad_sch]
2025-12-04 Cambios para realizarla en acido preparados
    [PCB_SALUS_III.kicad_pcb, PCB_SALUS_III.kicad_sch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]
2026-01-09 Se agrega Word con cosas necesarias para Salus IV
2026-01-14 no se que cambio
    [PCB_SALUS_III.kicad_sch]
